ina3538200965/stm32-data-acquisition/User/main.c

/**
  ******************************************************************************
  * @file    main.c
  * @brief   程序入口 —— 只做一件事：把控制权交给应用层
  *
  *          分层约定：
  *            main.c      只写调用顺序，不写任何业务逻辑
  *            app/        业务逻辑（不知道自己跑在 STM32 上）
  *            driver/     硬件相关代码（唯一能碰寄存器的地方）
  *            protocol/   纯软件协议（可脱离硬件在 PC 上测）
  *            test/       验证代码
  ******************************************************************************
  */
#include "app.h"


/**
  * @brief  主函数
  * @param  None
  * @retval int（裸机环境下不会返回）
  */
int main(void)
{
    APP_Init();
    while (1)
    {
        APP_Task();
    }
}
