ina3538200965/stm32-data-acquisition/(commit log)

2026-10-14 refactor: 拆分 driver/app/protocol/test 四层模块目录并初始化 Git 仓库
    原来所有代码都在 User/ 下，main.c 里直接操作 GPIO 寄存器，
    能编译但讲不清"换一块芯片要动哪些代码"。本次重构把职责切开：
    仓库相关
    - 新建 .gitignore：Objects/ Listings/ 等编译产物、*.uvoptx 与 *.uvguix.*
    （含本机绝对路径和 Windows 用户名，提交即泄露）、DebugConfig/、私人文档
    - 新建 .gitattributes：C 源码按 CRLF 检出，Markdown/YAML 按 LF，避免换行混用
    - Project.uvprojx 保留并提交（工程结构 = 源文件清单 + 芯片型号 + IncludePath）
    分层结构
    - driver/driver_led.c：GPIO/时钟配置与"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
2026-10-15 TIM3触发ADC多通道扫描 + USART1打印
2026-10-16 ADC 改用DMA循环搬运 + 验收记录
2026-10-19 I2C驱动MPU6500六轴+温度，含陀螺仪零偏校准
2026-10-20 feat: D5 I2C OLED 实时显示 + SPI Flash 掉电存储
2026-10-20 D5 I2C OLED 实时显示 + SPI Flash 掉电存储
2026-10-20 D6 自定义帧协议：CRC16 + 帧尾 + 逐字节状态机解析
    帧格式 AA 55 LEN CMD PAYLOAD CRC16(小端) EOF，固定开销 7 字节。
    靠 LEN 定位边界，所以不需要转义字符。
    - protocol.c/h：CRC16/Modbus（多项式 0xA001，初值 0xFFFF）流式计算
    CRC16_Update，收完 CRC 高字节即判定，不等帧尾，早一字节发现错帧
    - PROTO_Feed 8 态状态机，一次吃一个字节，返回 OK/BUSY/ERR_CRC/ERR_EOF/ERR_LEN
    不需要"攒够一帧再解析"，天然支持分包粘包
    - 命令字：ADC_DATA/MPU_DATA/STATUS/SET_RATE/GET_INFO/ACK
    - driver_usart：新增 SendBuf 阻塞发送
    - test_protocol.c：11 个用例 956 断言全过，含 CRC 公开测试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
2026-10-20 D8 上位机终端版；修 ADC 帧 seq 语义导致的丢帧误报
    上位机（host/）：
    - monitor.py：Python + pyserial，用与 MCU 侧 PROTO_Feed 完全相同的
    逐字节状态机做流式解析，来一个字节处理一个字节，天然抗分包粘包
    - SeqChecker：靠 ADC 帧的 seq 跳号查丢帧，并识别 MCU 复位（序号回绕）
    - frame_check.py：离线校验抓到的 hex，新增 pack() 组帧
    - 支持 --list / --selftest（不开串口自检解析与判据）
    - 统计：误帧率、丢帧、帧率、真实采样率
    修丢帧误报（这次真正的问题）：
    - 原先 seq 直接填 g_adcRoundCount（累计采样轮数）。ADC 是
    100Hz 采样、1Hz 上报，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
    [app.c, frame_check.py, monitor.py]
2026-10-21 D7 串口接收改 DMA + 环形缓冲
    两级缓冲：
    上位机 → USART → DMA1_Ch5 Circular(128B) → 中断搬运 → ring(512B) → 主循环
    - DMA 用 Circular 而非 Normal：Normal 收满要停下重装再启动，
    重启那几微秒到达的字节会丢，Circular 没有停止窗口
    - IDLE 中断负责"一帧发完了"的即时通知，比等 DMA 半满快得多。
    坑：IDLE 标志对 USART_ClearFlag 无效，必须依次"读 SR + 读 DR"清除，
    忘了会导致中断反复进入、主循环饿死，现象是程序卡住但没死
    - DMA 的 HT/TC 是兜底：上位机连续猛发时总线一直不闲、IDLE 永远不来，
    128B 会被覆盖。开半满/满中断后最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
2026-10-21 D7 下行命令与边界测试记录（双向通信打通）
    MCU 侧：
    - 主循环从环形缓冲取字节，逐字节喂 PROTO_Feed
    分包粘包不需要额外代码：一次取到几个字节完全是随机的，
    半帧会停在状态机里等下一半，几帧连着到就连续吐出多个 OK
    - CMD_GET_INFO 回 28 字节体检报告：采样轮数、已发帧数、上报周期、
    环形缓冲峰值与溢出、下行各类错误计数、三个外设是否在线、串口 ORE
    - CMD_SET_RATE 改上报周期（限 100~60000ms），取代原来写死的 100 tick
    - ACK 的 payload 第 0 字节放被应答的命令字 ——
    异步通信里没有这一条，收到应答都不知道自己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
2026-10-27 docs: 补硬件接线实物图
    清单「GitHub 仓库必须放的东西」第 1 条就是 README + 接线图，
    之前只有文字描述，补一张面包板实际接线的照片。
    - docs/images/hardware-setup.jpg（原图 713 KB 压到 229 KB，1400x1050）
    - README 的「硬件环境」章节加了「实物接线」小节，配图说明各模块位置
2026-10-28 docs: 补齐全部外设连线详情
    把原来 5 行的「引脚分配」扩成完整接线手册，12 个小节：
    - 引脚总表：17 个已用引脚，含 GPIO 模式、方向、5V 容忍标记
    - 电源与地：三路供电来源、电流预算、5 个电源坑、BOOT0 跳线
    - ADC / USART1 / I2C1 / SPI1 / LED+打点 / SWD 逐个外设接线表
    - 一页速查清单 + Mermaid 系统连接图
    - 未使用引脚清单（可扩 6 路 ADC 的依据）
    - 6 步搭建顺序 + 10 条故障对照表
    所有引脚与模式均从 driver/*.c 逐项核对，不是凭印象写的。
